alexj0i/2425_projet1a_pedale_midi/README.md

# Projet 1A Pédale MIDI

Ce projet vise à concevoir une pédale autonome destinée aux musiciens souhaitant contrôler facilement des sons MIDI. L'utilisateur peut naviguer entre différents programmes MIDI grâce à deux boutons **UP/DOWN**, et ajuster en temps réel un paramètre tel que le **volume** ou la **modulation** via une **pédale d’expression analogique**.

## Sommaire

- [Équipe](#équipe)
- [Description des dossiers](#description-des-dossiers)
- [Cahier des charges](#cahier-des-charges)
- [I. Partie Hardware](#i-partie-hardware)
  - [Architecture générale](#architecture-générale)
  - [Schéma électronique](#schéma-électronique)
  - [Détail des blocs matériels](#détail-des-blocs-matériels)
    - [1. Microcontrôleur](#1-microcontrôleur)
    - [2. Alimentation](#2-alimentation)
    - [3. Entrée analogique – Pédale d’expression](#3-entrée-analogique--pédale-dexpression)
    - [4. Affichage LED 7 segments](#4-affichage-led-7-segments)
    - [5. Entrées utilisateur – Boutons poussoirs](#5-entrées-utilisateur--boutons-poussoirs)
    - [6. Communication MIDI](#6-communication-midi)
    - [7. Programmation / Debug](#7-programmation--debug)
  - [Conception du PCB](#conception-du-pcb)
    - [Organisation des couches](#organisation-des-couches)
    - [Placement des composants](#placement-des-composants)
    - [Routage et bonnes pratiques](#routage-et-bonnes-pratiques)
    - [Fonctions complémentaires](#fonctions-complémentaires)
- [II / PARTIE SOFTWARE](#iipartie-software)
  - [Notions clefs](#notions-clefs)
    - [1. Définition du MIDI](#1-definition-du-midi)
    - [2. Forme d’un message MIDI](#2-forme-dun-message-midi)
  - [Objectifs de programmation](#objectifs-de-programmation)
    - [1. Interaction entre la STM32, les périphériques d’entrée et le système MIDI](#1-interaction-entre-la-stm32-les-périphériques-dentrée-et-le-système-midi)
    - [2. Les éléments à coder](#2-les-élements-à-coder)
  - [Code et projet](#code-et-projet)
    - [1. Agencement du projet dans STM32CubeIDE](#1-agencement-du-projet-dans-stm32cubeide)
    - [2. Le code et explications détaillées](#2-le-code-et-explications-détaillées)

  - [3. Paramétrage de la STM32 (pin, TIMER, interruptions)](#3-paramétrage-de-la-stm32-pin-timer-interruptions-)
  - [4. Résumé du fonctionnement SOFTWARE](#4-résumé-du-fonctionnement-software)
- [III / PARTIE TEST FONCTIONNEL](#iii-partie-test-fonctionnel)
    - [Test des boutons UP / DOWN](#test-des-boutons-up--down)
    - [Test de la pédale](#test-de-la-pédale-dexpression)
    - [Test de l'afficheur](#test-de-laffichage-7-segments)
    - [Test de l'alimentation](#test-de-lalimentation)

## Équipe  
- **TURGUT Iprahim**  
- **PREVOST Alexian**  
- **CHERIFI Sacha**

## Description des dossiers 
- Doc : 
  - datasheets
      * Fichier g21u.pdf : documentation technique du pédalier "Guitar Effects Pedal G2.1u".
      * Fichier NJL5167K.pdf : documentation  technique du capteur photoélectrique.
      * Fichier DTA123JCAHZGT116 : documentation technique du transistor.
      * Schema ampliOp original
  - ImgReadme
      *  Stockage des images pour le compte rendu
  - Presentation du projet : 2425_presentation_projets_1A_Fiack.pdf
- Hardware :
    * On retrouve ici la schématique ainsi que le PCB du projet réalisé sur le logiciel Kicad.
- Software :
    * Emplacement de la partie programmation sur le logiciel STM32CubeIde. 

## Cahier des charges 

Le projet "Pédale MIDI" a pour objectif de développer une pédale MIDI autonome permettant à un utilisateur, notamment un musicien, de naviguer entre différents sons MIDI à l’aide de deux boutons (UP/DOWN) et de contrôler en temps réel un paramètre comme le volume ou la modulation via une pédale d’expression analogique. Le système repose sur un microcontrôleur STM32G431KBTx chargé de gérer les entrées (boutons et pédale via GPIO et ADC), l’affichage du programme sélectionné sur un écran 7 segments double via un multiplexage piloté par un timer (TIM4), et la transmission des messages MIDI (Program Change et Control Change) au format UART vers un PC ou un instrument. Le dispositif doit être compact, alimenté en 5V avec régulation locale en 3.3V, intégrer un affichage clair et une connectique accessible, tout en respectant des contraintes de stabilité, de simplicité d'utilisation et de fiabilité en conditions de jeu.

## I / PARTIE HARDWARE

### Architecture Générale

Le système repose sur une carte STM32 qui centralise la lecture des entrées (pédale, boutons), l'afficheur 7 segments, et la transmission MIDI via UART. L’ensemble est alimenté en **3,3 V**, régulé à partir d’une source **+5 V**.

---

### Schéma Électronique

Le schéma du projet a été réalisé sur **KiCad**. Voici le visuel de la schématique ci-dessous :

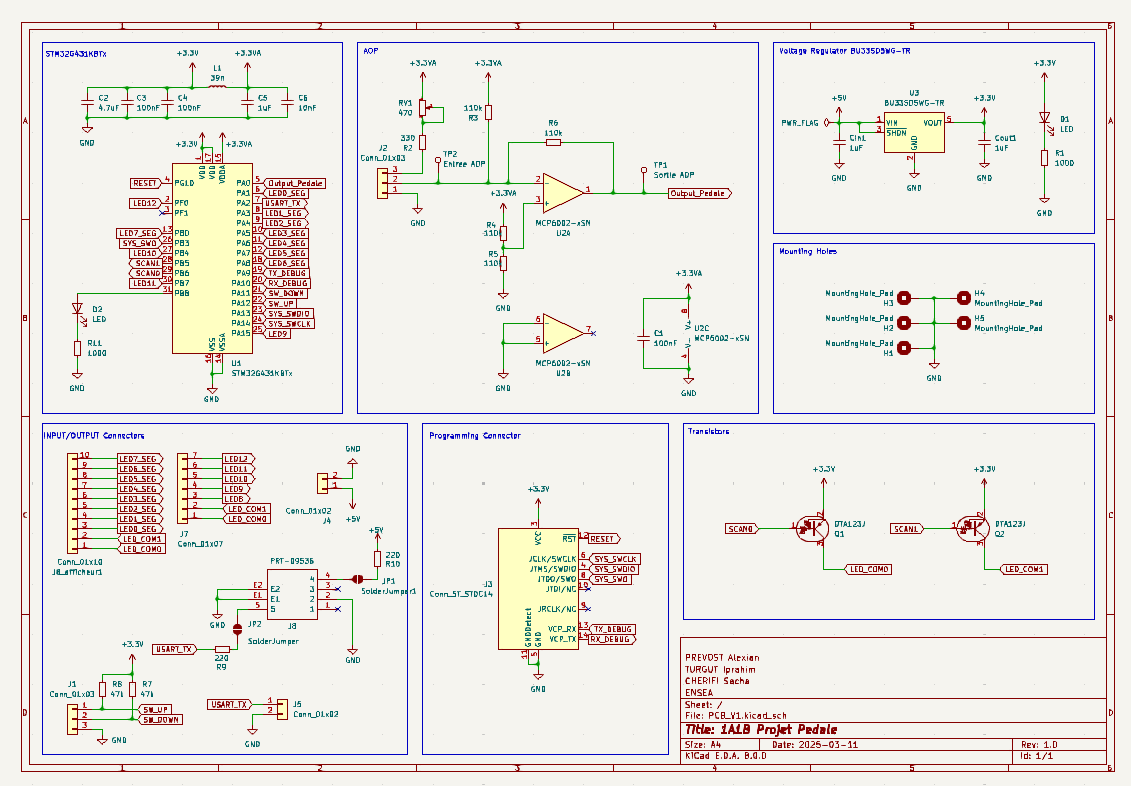
[picture p1: Doc/ImgReadme/Schematique_pedale.PNG]
.

Il contient :

- **Unité centrale** : STM32G431KBTx
- **Conditionnement du signal de pédale** via AOP
- **Commande des LED 7 segments** avec transistors PNP à résistances intégrées
- **Régulation d’alimentation 5V → 3.3V**
- **Connecteurs** : connecteur STDC14 entrées boutons, affichage LED, communication série

---

### Détail des blocs matériels

#### 1. Microcontrôleur
- **Référence** : STM32G431KBTx  
- **Architecture** : ARM Cortex-M4, fréquence max 170 MHz  
- **Format** : LQFP-32  
- **Périphériques utilisés** :
  - **ADC1** pour lire la tension envoyée par la pédale (valeur analogique)
  - **GPIOs** pour lire l'état des boutons UP/DOWN
  - **EXTI** pour gérer les interruptions sur appuis bouton / pédale
  - **USART1 (UART)** pour la communication MIDI (sortie TX)
  - **TIM4** pour gérer le multiplexage de l'afficheur 7 segments (interruption périodique)
- **Alimentation** : 3.3V régulée par LDO
- **Avantages** :
  - Microcontrôleur puissant et polyvalent
  - Intégration de nombreuses fonctionnalités sur un boîtier compact

#### 2. Alimentation
- **Composant principal** : BU33SD5WG-TR (Régulateur LDO)
- **Entrée** : +5V (via connecteur J5)
- **Sortie** : +3.3V (pour alimenter le microcontrôleur, les transistors, l’AOP)
- **Protection / filtrage** :
  - **Condensateurs** d’entrée et de sortie (1 µF chacun)
  - **LED** de visualisation d'alimentation (D1)
- **Pourquoi ce choix ?**
  - Faible dropout voltage
  - Très faible consommation de repos
  - Format compact (SOT-23-5)

#### 3. Entrée analogique – Pédale d’expression
- **Signal d’entrée** : tension analogique entre 0 V et 3.3 V issue d’un capteur optique (NJL5167K)
- **Conditionnement du signal** :
  - Utilisation d’un double AOP : **MCP6002**
    - Canal 1 : buffer (impédance d’entrée élevée, stabilité)
    - Canal 2 : amplificateur non-inverseur (gain défini par R6/R4)
  - **Potentiomètre (RV1 = 470 Ω)** pour réglage fin du gain ou de la tension de référence
  - **Filtrage** : R et C en entrée pour atténuer les perturbations haute fréquence
- **Pourquoi ce choix ?**
  - MCP6002 est un AOP **rail-to-rail**, faible consommation, économique
  - Compatible avec alimentation 3.3V

#### 4. Afficheur LED 7 segments
- **Nombre de chiffres** : 2 chiffres (double afficheur)
- **Commande** :
  - **Multiplexage** : affichage alterné via interruptions du TIM4
  - **Segments (a–g)** câblés en parallèle sur un port GPIO (ex: GPIOB)
  - **Anodes communes** : activées alternativement via 2 transistors
- **Transistors utilisés** :
  - **DTA123J** (Q1, Q2)
    - Transistors PNP avec résistances intégrées (R1 = 2.2 kΩ, R2 = 47 kΩ)
    - Pilotés par le microcontrôleur (commutation rapide, faible encombrement)
- **Pourquoi ce choix ?**
  - Réduction du nombre de broches GPIO (affichage multiplexé)
  - Meilleure lisibilité pour l’utilisateur
  - Moins de composants passifs nécessaires grâce aux transistors "pré-polarisés"

#### 5. Entrées utilisateur – Boutons poussoirs
- **Boutons** :
  - UP (J6) et DOWN (J6)
  - Pull-down via résistances de 47 kΩ (R7, R8)
  - Connexions sur GPIOs avec **interruptions EXTI**
- **Utilisation** :
  - Sélection de presets MIDI (valeurs entre 0 et 127)
  - Incrémentation / décrémentation de la variable `globalToDisplay`
- **Protection / rebond logiciel** :
  - Anti-rebond logiciel via `HAL_GetTick()` + temporisation 50 ms

#### 6. Communication MIDI
- **Interface** : UART via USART1
- **Niveau logique** : TTL 3.3V (compatible PC ou interface MIDI-USB)
- **Format des messages** :
  - **Program Change** : `[0xC0, num_programme]`
  - **Control Change** : `[0xB0, effet, valeur]`
- **Utilisation** :
  - Envoi vers un PC ou un synthétiseur logiciel
  - Communication unidirectionnelle (TX uniquement)

#### 7. Programmation / Debug
- **Connecteur STDC14 (J3)** :
  - Connexion au programmateur ST-Link
  - Accès aux signaux :
    - SWCLK, SWDIO (programmation/debug)
    - TX_DEBUG, RX_DEBUG (UART secondaire pour impression/log)
- **Pourquoi ce choix ?**
  - Connecteur standard ST utilisé à l’ENSEA
  - Facilité de reprogrammation et débogage en temps réel

## Conception du PCB

La carte électronique de la pédale MIDI a été conçue avec **KiCad** et repose sur un **PCB 4 couches**, permettant une organisation optimisée des signaux, de l’alimentation et du plan de masse.

---

### Organisation des couches

Le PCB utilise 4 couches réparties comme suit :

- **Couche 1 (Top Layer)** : Routage principal des signaux (GPIO, UART, ADC, affichage…).
- **Couche 2 (Inner Layer 1)** : Plan de masse complet, essentiel pour limiter les perturbations et garantir des références stables.
- **Couche 3 (Inner Layer 2)** : Plan d’alimentation (+ 3.3 V et + 3.3 VA), isolé du plan de masse pour éviter les couplages indésirables.
- **Couche 4 (Bottom Layer)** : Routage secondaire, signaux de commande, entrées utilisateur et connexions vers les périphériques.

Cette structure améliore la **stabilité électrique**, **limite les interférences**, et permet une **meilleure compacité** du design.

---

### Placement des composants

Le placement a été réfléchi selon une logique de blocs fonctionnels :

- Le **microcontrôleur STM32G431KBTx** est centré sur la carte pour limiter la longueur des pistes critiques.
- La **section AOP + pédale** est placée en bas à gauche, proche du connecteur J2 pour une lecture propre du signal analogique.
- Le **régulateur de tension (BU33SD5WG)** est positionné en haut à proximité des entrées d’alimentation (J4/J5).
- Les **transistors Q1 et Q2 (DTA123J)** sont proches du connecteur LED J7, pour commander les chiffres du double 7 segments.
- Tous les **connecteurs** sont en périphérie pour un accès facile :
  - J2 pour la pédale
  - J5 pour l’alimentation
  - J7 pour l’écran LED
  - J3 (STDC14) pour le débogage
  - J6 pour les boutons poussoirs

---

### Routage et bonnes pratiques

- **Pistes d’alimentation** élargies pour minimiser les chutes de tension.
- **Condensateurs de découplage** positionnés au plus près des broches VDD du microcontrôleur.
- **Vias traversants** utilisés avec parcimonie pour relier efficacement les couches.
- Les signaux sensibles (notamment le **signal ADC**) ont été routés avec soin pour éviter les interférences.
- Le **multiplexage de l'affichage** a été routé de façon à réduire les croisements de pistes.

---

### Fonctions complémentaires

- **Jumpers JP1/JP2** : utilisés pour activer ou désactiver certaines fonctions (ex : liaison série ou configuration debug).
- **Points de test TP1/TP2** : permettent de vérifier le signal analogique traité par les AOP.
- **Trous de fixation** (H1–H5) : assurent une intégration mécanique solide de la carte dans un boîtier.

---

### Aperçu du PCB
  
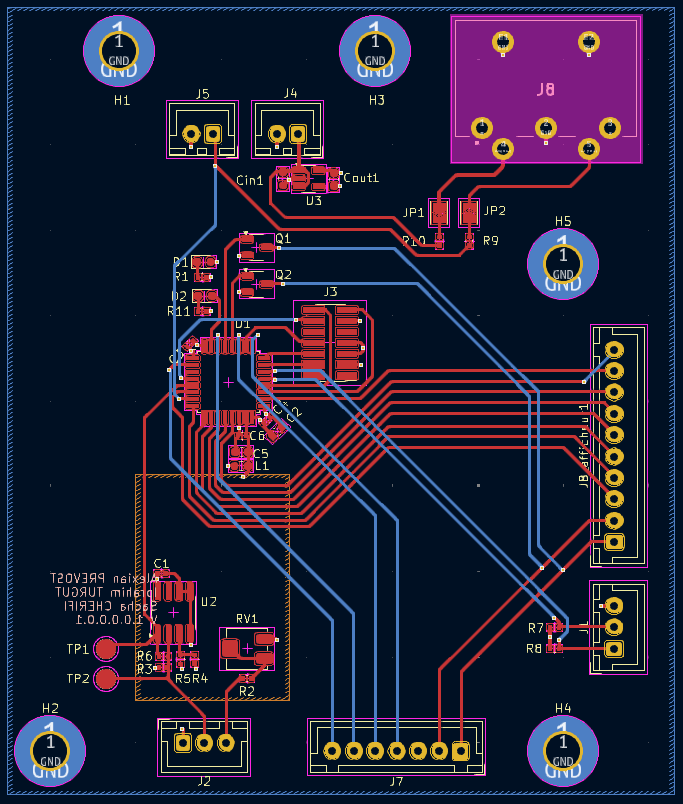
[picture p2: Doc/ImgReadme/PCB_pedale.PNG]
> .
> *Vue du routage et du placement des composants sur 4 couches.*

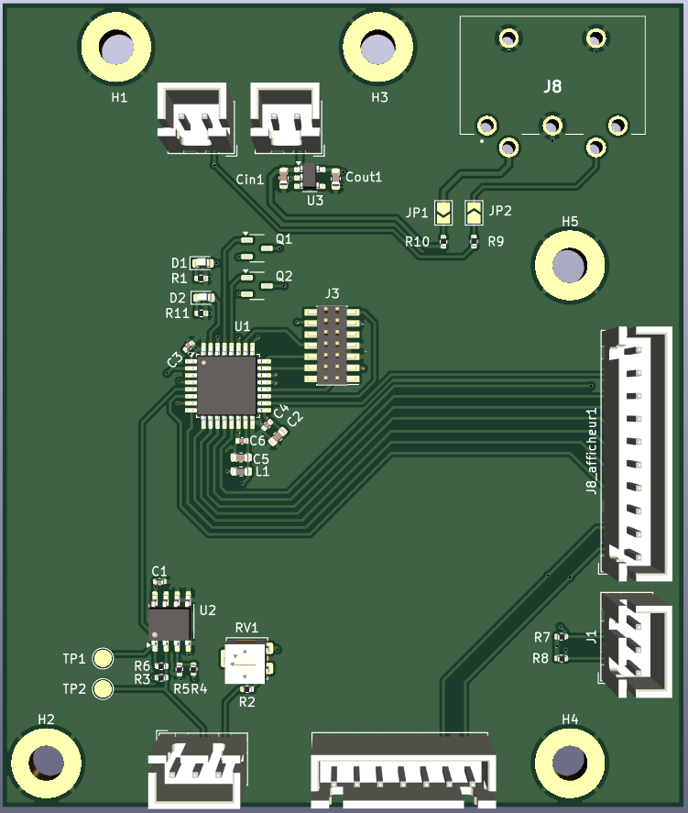
[picture p3: Doc/ImgReadme/Visu3D_pedale.PNG]
> .
> *Vue en 3D du PCB*

### Justification du choix des composants

| Composant | Rôle | Justification |
|---|---|---|
| STM32G431KBTx | Contrôle principal | Compatibilité ADC, UART, TIM, GPIO. Format compact. |
| MCP6002 | AOP pour pédale | Rail-to-rail, faible consommation, économique. |
| DTA123J | Commutation LED | Transistors PNP avec résistances intégrées → gain de place. |
| BU33SD5WG | Régulateur | Régulation stable 3.3V, faible chute de tension. |
| RV1 (470 Ω) | Réglage de gain | Permet un calibrage manuel de la pédale. |
| Afficheur 7 segments| Retour visuel utilisateur| Simple, lisible, facilement multiplexé avec 2 chiffres. |

# II/PARTIE SOFTWARE
# Notions clefs
## **1. DEFINITION DU MIDI**
Le **MIDI** (abréviation de **Musical Instrument Digital Interface**) est un Protocole de communication et un format de fichier destinés à la musique, et utilisés pour la communication entre instruments électroniques, contrôleurs, séquenceurs, et logiciels de musique.
## **2. FORME D'UN MESSAGE MIDI** 

| Message |Status | Data1|Data2|
|---|---|---|---|
|Control Change (CC)|1011 CCCC |Control number (0-119) |Value (0-127)|
| Program Change | 1100 CCCC | Program number |N/A |

* **Control Change**
>Envoie un message MIDI pour contrôler un effet ( exemple : le volume , un pédale d'expression , etc )
>> * **Byte de statut (`status`)**
>>  De la forme `0xBn` :
>>`B` indique qu’il s’agit d’un message Control Change 
>>`n` indique le numéro du canal MIDI ( de 0 à 15 soit les channels MIDI de 1 à 16 ).
>>Dans notre cas, le **byte de statut** sera toujours égal à `0xB0`, car `B` indique un message de type **Control Change**, et nous utilisons arbitrairement le **canal 0**, qui correspond au **canal MIDI 1**.
>
>> * **Byte de la premiere donnée (`data1`)**
>> data1 est le numéro du contrôleur c'est à dire l'effet appliqué ( de 0 à 127 ). 
>
>> * **Byte de la deuxième donnée (`data2`)**
>data 2 est la valeur du contrôleur c'est à dire la valeur de l'effet souhaité ( de 0 à 127 ). 
>
>***Exemple pratique**: On veut envoyer une message Control Change sur le cannal MIDI 1 de manière à mettre le volume le plus fort possible. On prendra  :
>Message = [0xB0, 7, 127]*

* **Program Change**
>Envoie un message MIDI pour changer de preset ou d'instrument VST.
>> * **Byte de statut (`status`)**
>>  De la forme `0xCn` :
>>`C` indique qu’il s’agit d’un message Program Change 
>>`n` indique le numéro du canal MIDI ( de 0 à 15 soit les channels MIDI de 1 à 16 ).
>>Dans notre cas, le **byte de statut** sera toujours égal à `0xC0`, car `C` indique un message de type **Control Change**, et nous utilisons arbitrairement le **canal 0**, qui correspond au **canal MIDI 1**.
>
>> * **Byte de la premiere donnée (`data1`)**
>> data1 est le numéro du programme c'est à dire le preset ou l'instrument ( de 0 à 127 ). 
>
>> * **Byte de la deuxième donnée (`data2`)**
>data2 n'est **pas utilisée.**
>
>***Exemple pratique**: On veut envoyer une message Program Change sur le cannal MIDI 1 de manière à utiliser un son de piano ( 0 pour un Acoustic Grand Piano dans la banque de sons MIDI ) . On prendra alors:
>Message = [0xC0, 0]*
>

# Objectifs  de programmation
## **1. Interaction entre la STM32, les périphériques d’entrée et le système MIDI**
```mermaid
graph TD
    A[Bouton +/-] -->|GPIO EXTI| B[STM32]
    C[Pédale] -->|ADC + EXTI| B
    B -->|UART MIDI | D[PC: Logiciel MIDI]
    B -->|TIM4 + Screen_display| E[Écran 7 segments 2 chiffres]
```
## **2. Les élements à coder**
 * **Ecran 7 cadrants 2 chiffres**
>Affiche le numéro du son sélectionné dans la banque MIDI.  
Ce numéro est mis à jour selon l’appui sur les boutons **UP** ou **DOWN**.  
L’écran offre un retour visuel clair à l’utilisateur.
>
* **Boutons de selection des sons**
>Permettent de naviguer dans la banque de sons MIDI (de 0 à 127).  
Chaque appui incrémente ou décrémente le numéro de programme.
>
 * **Pedale**
>Connectée à l’**entrée ADC**, elle mesure une tension analogique.  
Sa valeur est convertie en valeur MIDI (0–127).  
Elle permet un **contrôle en temps réel** d’un paramètre MIDI (volume, sustain, etc).
>
 * **Communication MIDI**
>La STM32 envoie les messages MIDI via **UART**.  
Elle transmet les changements de sons ou de contrôle vers un PC.
La STM32 agit comme **contrôleur MIDI autonome**.

# **Code et projet**
## **1. Agencement du projet dans STM32CubeIDE**
```mermaid
classDiagram
    class Main {
        <<main.c>>
        int last_button_time
        void HAL_GPIO_EXTI_Callback()
        void HAL_TIM_PeriodElapsedCallback()
    }

    class MIDI {
        <<midi.c>>
        void ProgramChange(int MIDISoundNumber)
        void ControlChange(int pedalValue, int effect)
        int ADValue()
    }

    class Screen {
        <<screen.c>>
        int array
        int global_to_display
        void screen_display()
    }

    Main --> MIDI : appelle
    Main --> Screen : appelle
    Screen --> MIDI : utilise global_to_display

```
## **2. Le code et explications détaillées**
**Contenu du midi.c :** 
* **Fonction ControlChange**
```
void  ControlChange(int pedalValue, int effect)
{
int message[3] = {0xB0, effect, pedalValue}; 
HAL_UART_Transmit(&huart1, message, 3, HAL_MAX_DELAY);
}
```
>--- ***Pourquoi cette fonction ?*** ---
>
>Un **Control Change** permet de **modifier des paramètres en temps réel**, comme le volume.
> * `message[3]` est un tableau de 3 octets, correspondant à un message **MIDI Control Change**. Ici, le message MIDI signifie :  *"Change la valeur de l'`effect` voulu sur le canal MIDI 1 avec la valeur `pedalValue`."*
>* La fonction `HAL_UART_Transmit` envoie ce message via la liaison **série UART**.

* **Fonction ProgramChange**
```
void ProgramChange(int MIDISoundNumber)
{
int message[2] = {0xC0, MIDISoundNumber};
HAL_UART_Transmit(&huart1, data, 2, HAL_MAX_DELAY);
}
```
>--- ***Pourquoi cette fonction ?*** ---
>
>Un **Program Change** permet de **changer le son ou le preset** utilisé par  l'instrument.
> * `message[2]` est un tableau de 2 octets, correspondant à un message **MIDI Program Change**. Ici, le message MIDI signifie :  *"Change le programme (son) de l'instrument sur le canal 1 pour le programme `MIDISoundNumber`."*
>* La fonction `HAL_UART_Transmit` envoie ce message via la liaison **série UART**.

* **Fonction  pour le potentiometre (valeur ADC)**
``` 
uint8_t ADCValue(void)
{
    HAL_ADC_Start(&hadc1);
    HAL_ADC_PollForConversion(&hadc1, HAL_MAX_DELAY);
    uint32_t lastADCValue = HAL_ADC_GetValue(&hadc1); 
    HAL_ADC_Stop(&hadc1); // economie d'energie on éteint l'adc si il n'est pas utilisé.
    return (uint8_t)((lastADCValue * 127) / 4095);
}
```
>--- ***Pourquoi cette fonction ?*** ---
>
> Un **ADC** (Analog-to-Digital Converter) permet de convertir une **tension analogique** (par exemple entre **0V et 3.3V**) en une **valeur numérique** exploitable par un microcontrôleur.  
Si l’ADC est en **résolution 12 bits**, il produit des valeurs comprises entre **0 et 4095**. Or, dans le protocole **MIDI**, les données comme les valeurs de contrôle sont codées sur **7 bits**, c’est-à-dire de **0 à 127**.
Ainsi, pour utiliser une valeur provenant de l’ADC dans un message MIDI, il est nécessaire de convertir la plage **0–4095** vers la plage **0–127**.
>* `HAL_ADC_PollForConversion(&hadc1, HAL_MAX_DELAY)` permet d'attendre que la conversion se fasse correctement.
>* `HAL_ADC_GetValue(&hadc1)` lit la dernière **valeur convertie par l’ADC**.
>`adcValue` sera une valeur comprise entre **0 et 4095** (12 bits).
>
> * `(uint8_t)((adcValue * 127) / 4095)` **convertit** la valeur 12 bits (0–4095) en 7 bits (0–127), proportionnellement  et le **cast** en `(uint8_t)` assure que la valeur retournée est bien entre 0 et 127.

**Contenu du midi.h :** 
```
#include "main.h"

#define BUTTON_UP GPIO_PIN_12
#define BUTTON_DOWN GPIO_PIN_11
#define PEDAL GPIO_PIN_0
#define EFFECT 7 //Volume

void ProgramChange(int MIDISoundNumber);
void ControlChange(int pedalValue, int effect);
uint8_t ADCValue(void);
```

**Contenu du screen.c :** 
* **Multiplexage pour l'affichage de l'écran 7 cadrants**
```
int globalToDisplay;

//Ordre : A B C D E F G (mappés sur bits 1 3 4 5 6 7 8)
const uint16_t array[10] = {
    (0<<1)|(0<<3)|(0<<4)|(0<<5)|(0<<6)|(0<<7)|(1<<8), // 0
    (1<<1)|(0<<3)|(0<<4)|(1<<5)|(1<<6)|(1<<7)|(1<<8), // 1
    (0<<1)|(0<<3)|(1<<4)|(0<<5)|(0<<6)|(1<<7)|(0<<8), // 2
    (0<<1)|(0<<3)|(0<<4)|(0<<5)|(1<<6)|(1<<7)|(0<<8), // 3
    (1<<1)|(0<<3)|(0<<4)|(1<<5)|(1<<6)|(0<<7)|(0<<8), // 4
    (0<<1)|(1<<3)|(0<<4)|(0<<5)|(1<<6)|(0<<7)|(0<<8), // 5
    (0<<1)|(1<<3)|(0<<4)|(0<<5)|(0<<6)|(0<<7)|(0<<8), // 6
    (0<<1)|(0<<3)|(0<<4)|(1<<5)|(1<<6)|(1<<7)|(1<<8), // 7
    (0<<1)|(0<<3)|(0<<4)|(0<<5)|(0<<6)|(0<<7)|(0<<8), // 8
    (0<<1)|(0<<3)|(0<<4)|(0<<5)|(1<<6)|(0<<7)|(0<<8), // 9
};

void  screenDisplay(void) 
{
static  int displayNumber = 0;
	//Effacement de la virgule pour l'afficheur
    HAL_GPIO_WritePin(GPIOB, DOT_PIN, GPIO_PIN_SET);

	//Initialisation des segments (1,3,4,5,6,7,8)
		GPIOA->ODR &= ~( (1<<1) | (1<<3) | (1<<4) | (1<<5) | (1<<6) | (1<<7) | (1<<8) );
		
if (displayNumber == 0) 
	{
	GPIOB->ODR = array[globalToDisplay / 10];
	HAL_GPIO_WritePin(GPIO_PORT_B, COM0, GPIO_PIN_SET); // COM0 = 1
	HAL_GPIO_WritePin(GPIO_PORT_B, COM1, GPIO_PIN_RESET); // COM1 = 0
} 

else
	{
	GPIOB->ODR = array[globalToDisplay % 10]; 
	HAL_GPIO_WritePin(GPIO_PORT_B, COM0, GPIO_PIN_RESET); // COM0 = 0
	HAL_GPIO_WritePin(GPIO_PORT_B, COM1, GPIO_PIN_SET); // COM1 = 1
	}
	displayNumber = 1 - displayNumber;
}
```
>--- ***Pourquoi cette fonction ?*** ---
>
>`screenDisplay()` qui gère l’affichage des deux chiffres d’un écran 7 segments. Grâce au multiplexage, chaque chiffre est allumé alternativement très rapidement, ce qui donne l’illusion qu’ils sont allumés en même temps.
> * `globalToDisplay`contient **le nombre à afficher** (entre 0 et 99).
> * `const uint8_t array[10]` contient les **valeurs binaires** à envoyer aux segments (a–g) du 7 segments pour afficher les chiffres de 0 à 9.
>> Si on doit afficher **le chiffre des dizaines** (` if (displayNumber == 0) `)
> `GPIOB->ODR = array[globalToDisplay / 10];` permet d'afficher le chiffre des dizaines sur l'écran 7 segments. Elle divise la valeur `globalToDisplay` par 10 pour extraire le chiffre des dizaines, puis utilise ce résultat comme index dans le tableau `array` pour récupérer le motif binaire correspondant aux segments à allumer. Ensuite, ce motif est écrit dans le registre `GPIOB->ODR`, ce qui active les bons segments du chiffre sur l'afficheur.
Les commandes :
>`HAL_GPIO_WritePin(GPIO_PORT_B, COM0, GPIO_PIN_SET); 
>HAL_GPIO_WritePin(GPIO_PORT_B, COM1, GPIO_PIN_RESET); `
Activent le chiffre des dizaines et désactive le chiffre des unités.
>> Si on doit afficher **le chiffre des unités** (`else`)
>  `GPIOB->ODR = array[globalToDisplay % 10];` fait de même que précèdemment pour le chiffre des unités.
Les commandes :
>`HAL_GPIO_WritePin(GPIO_PORT_B, COM0, GPIO_PIN_RESET); 
>HAL_GPIO_WritePin(GPIO_PORT_B, COM1, GPIO_PIN_SET); `
Activent le chiffre des unités et désactive le chiffre des dizaines.
>* `displayNumber = 1 - displayNumber;`
Alterne la valeur de `displayNumber` entre 0 et 1 à chaque appel. Elle permet de basculer l’affichage entre les deux chiffres du 7 segments pour réaliser le multiplexage.

**Contenu du screen.h :** 
```
#include "main.h"

#define DOT_PIN GPIO_PIN_0 
#define GPIO_PORT_B GPIOB
#define COM0 GPIO_PIN_5
#define COM1 GPIO_PIN_6

// Variable globale pour stocker le nombre à afficher
extern int globalToDisplay;

void screenDisplay(void);
```

**Contenu du main.c :** 
* **Interruptions et TIMER**
```
int lastButtonTime = 0; 

void  HAL_TIM_PeriodElapsedCallback(TIM_HandleTypeDef *htim) 
{
if (htim->Instance == TIM4)
	{
	screenDisplay();
	ControlChange(ADCValue(), EFFECT); // Il faudrait faire un autre TIMER pour cette ligne
	}
}

void  HAL_GPIO_EXTI_Callback(int GPIO_Pin)
{
if ((HAL_GetTick() - lastButtonTime) > 50)
	{ 
	switch(GPIO_Pin)
		{
		case BUTTON_UP:
			globalToDisplay++;
			if (globalToDisplay > 127)
				{
				}
			ProgramChange(globalToDisplay);
			break;
			
		case BUTTON_DOWN:
			globalToDisplay--;
			if (globalToDisplay < 0)
				{
				}
			ProgramChange(globalToDisplay);
			break;
			
	 }
	lastButtonTime = HAL_GetTick();
 }
}
```
>--- ***Pourquoi ce code ?*** ---
>
>Ce code gère **l'affichage de l'écran** et la **gestion des boutons et de la pédale**. Il utilise un **TIM4** pour le multiplexage de l’écran, et des **interruptions GPIO** pour réagir aux appuis boutons et à la pédale.
>* `void HAL_GPIO_EXTI_Callback(int GPIO_Pin)` se déclenche automatiquement lors d’une interruption sur un bouton ou la pédale i.e lors d'un appui d'un des boutons ou de la pédale.
>> Dans le cas ou le bouton d'incrémentation est préssé (`case BUTTON_UP:`):
 On incrémente `globalToDisplay` pour passer au **son suivant** et on envoie un message MIDI **Program Change** via`ProgramChange(globalToDisplay)`.
 >>
 >>Dans le cas ou le bouton d'incrémentation est préssé (`case BUTTON_DOWN:`):
 On décrémente `globalToDisplay` pour passer au **son précédent** et on envoie un message MIDI **Program Change** via`ProgramChange(globalToDisplay)`.
 >>
>>Dans le cas ou la pédale est préssée en passant par un TIMER:
  On envoie une commande MIDI de type **Control Change** qui modifie la valeur de l'`EFFECT` suivant la valeur de la lecture de l'**ADC** via `ADCValue()`.

## **3. Paramétrage de la STM32( pin, TIMER, interruptions )**

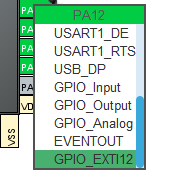
[picture p4: Doc/ImgReadme/GPIOexti.png]
.
>Les pins PA11 et PA12 correspondent aux lignes d’interruption EXTI11 et EXTI12. 

Texte alternatif Titre de l'image.
>En activant EXTI10–15, on captures les événements sur ces deux lignes donc nos appuis des boutons UP et DOWN.

Texte alternatif Titre de l'image.
>On active l’interruption du TIM4 pour que le microcontrôleur réagisse automatiquement quand le timer a fini de compter jusqu’à la valeur 7999

Texte alternatif Titre de l'image.
>On règle avec PRESCALER et ARR la vitesse d’exécution de l’interruption pour gérer l’affichage sans scintillement sur le cadran.
$`\text{Fréquence du timer} = \frac{170\,000\,000}{(19 + 1) \cdot (7999 + 1)} = 1062.5 \, \text{fois par seconde}`$

## **4. Résumé du fonctionnement SOFTWARE**
```mermaid
sequenceDiagram
    participant Bouton as Bouton/Pedalier
    participant STM32 as STM32 (Code)
    participant UART as UART (MIDI Out)
    participant PC as Logiciel MIDI (PC)

    Note over Bouton,STM32: Appui sur le bouton
    Bouton->>STM32: GPIO_EXTI_Callback(BTN_UP/BTN_DOWN)
    activate STM32

    STM32->>STM32: Anti-rebond (HAL_GetTick())
    STM32->>STM32: Inc/Déc globalToDisplay (0-127)
    STM32->>STM32: ProgramChange(globalToDisplay)

    Note over STM32,UART: Envoi MIDI (Program Change)
    STM32->>UART: UART_Transmit([0xC0, num_son])
    deactivate STM32

    UART->>PC: Message MIDI 
    activate PC
    PC->>PC: Changement de son (instrument VST)
    deactivate PC

    Note over Bouton,STM32: Mouvement de la pédale
    Bouton->>STM32: TIM_PeriodElapsedCallback
    activate STM32
    STM32->>STM32: ADCValue() → pedalValue (0-127)
    STM32->>STM32: ControlChange(pedalValue, effect)

    Note over STM32,UART: Envoi MIDI (Control Change)
    STM32->>UART: UART_Transmit([0xB0, effect, valeur])
    deactivate STM32

    UART->>PC: Message MIDI 
    activate PC
    PC->>PC: Modulation d'effet (ex : Volume)
    deactivate PC
```

# III/ PARTIE TEST FONCTIONNEL

Après la conception et l’assemblage de la carte, plusieurs tests fonctionnels ont été réalisés afin de valider le bon fonctionnement de chaque bloc du système.

### Test des boutons UP / DOWN
- **But** : Vérifier l’incrémentation ou décrémentation du programme MIDI via les boutons.
- **Méthode** : Appui répété sur les boutons tout en observant l’afficheur 7 segments et les messages MIDI envoyés.
- **Résultat attendu** : L’affichage change entre 0 et 127, et chaque appui génère un message MIDI **Program Change** correctement transmis sur l’interface UART.

Voici une image représentant l'incrémentation en appuyant sur les boutons UP/DOWN :  
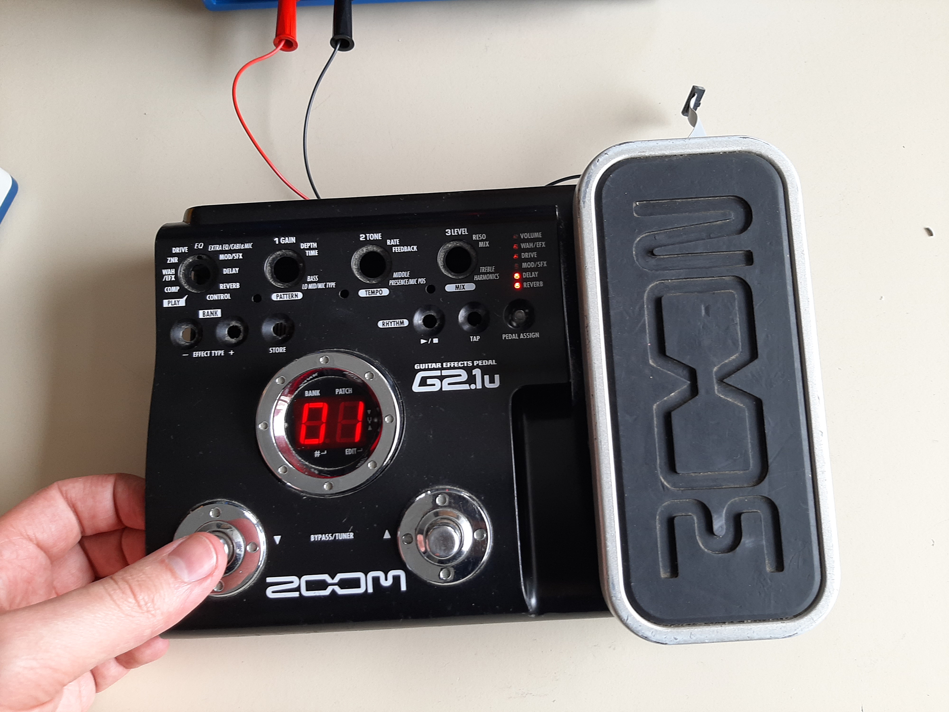
[picture p5: Doc/ImgReadme/20250526_165851.jpg]
> .

### Test de la pédale d’expression
- **But** : Vérifier que la position de la pédale est correctement traduite.
- **Méthode** : Vérification à l'aide d'un oscilloscope afin de réaliser une mesure de la tension analogique en sortie et consatater la variation de tension.
- **Résultat attendu** : La plage 0V–3.3V est bien convertie en une valeur de 0 à 127. On constate une variation de la tension à l'oscilloscope. Pour un meilleur visuel, nous avons utilisé les LEDs pour constater un variation linéaire de la tension. 

Voici des images représentant une variation de la tension, avec la pédale, à l'aide des LEDs  :
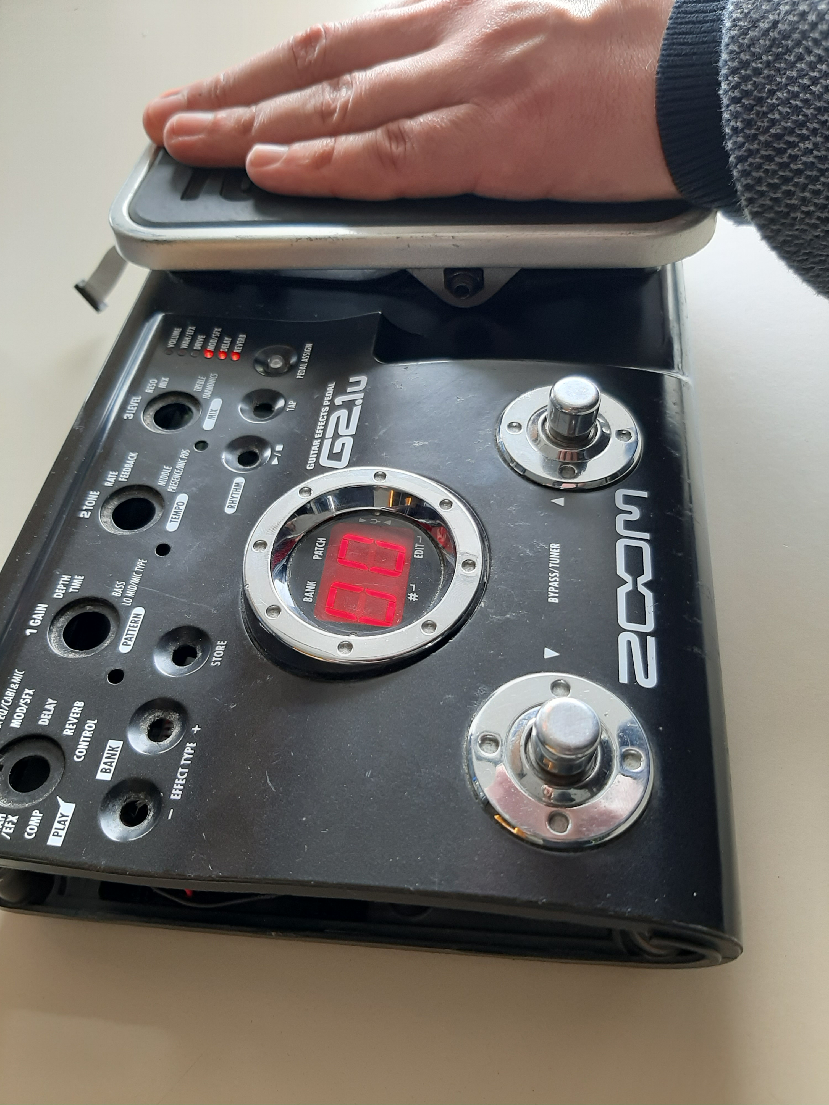
[picture p6: Doc/ImgReadme/20250526_165904.jpg]
> .
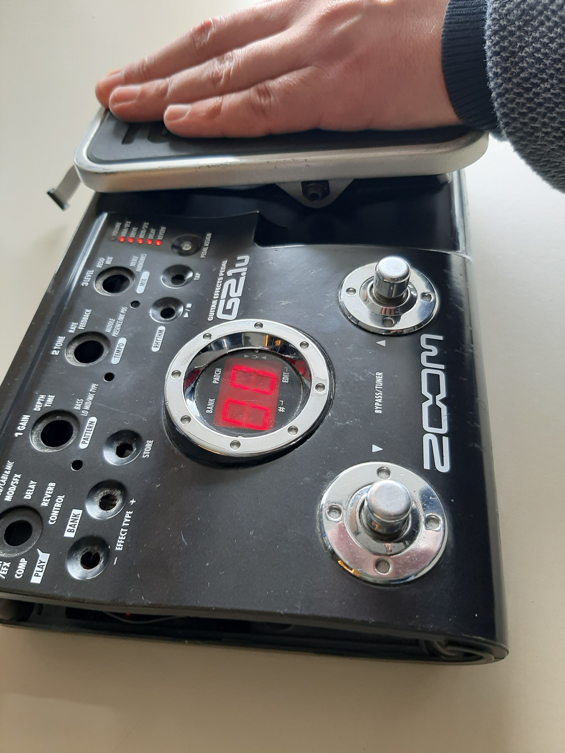
[picture p7: Doc/ImgReadme/20250526_165908.jpg]
> . 

Voici une image représentant une variation de la tension, avec la pédale, à l'aide de l'oscilloscope :

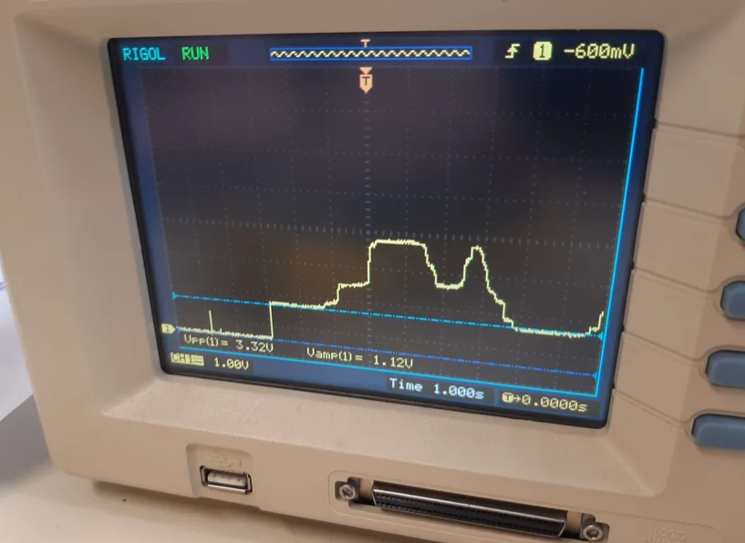
[picture p8: Doc/ImgReadme/osc1.PNG]
> .

### Test de l'afficheur 7 segments
- **But** : S’assurer que l’écran affiche correctement le numéro du programme MIDI.
- **Méthode** : Envoi manuel de valeurs de test dans la variable `globalToDisplay` (ou appui sur les boutons).
- **Résultat attendu** : Affichage stable, chiffres bien multiplexés, visibilité correcte même en environnement lumineux.

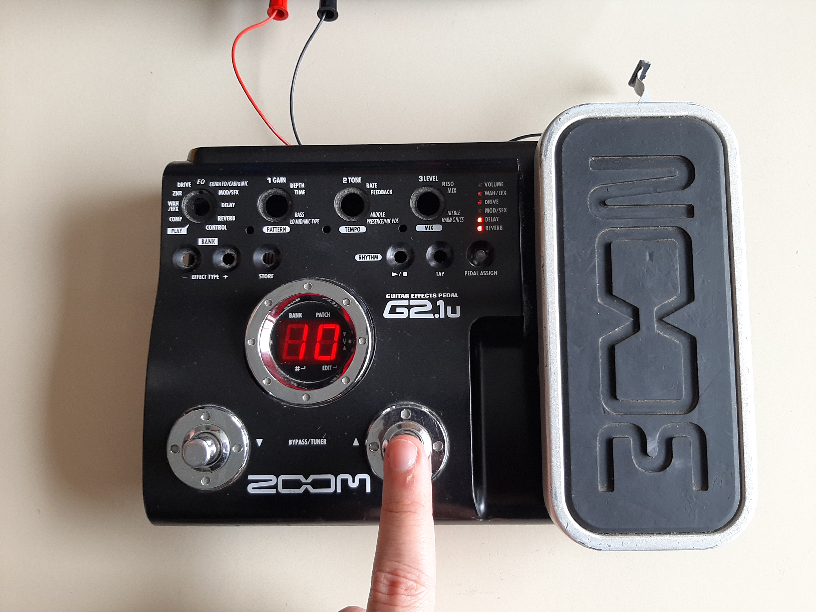
[picture p9: Doc/ImgReadme/20250526_165842.jpg]
> . 

### Test de l’alimentation
- **But** : Valider la stabilité des tensions d’alimentation 3.3V et 5V.
- **Méthode** : Mesure au multimètre, et affichage sur les LEDs.
- **Résultat attendu** : Tension de 3.3V régulée propre, sans oscillations ni chute lors de sollicitations.

## Conclusion

Le projet **Pédale MIDI** a permis de concevoir, réaliser et tester une solution matérielle et logicielle complète répondant à un besoin concret dans le domaine musical : offrir un contrôle simple, autonome et précis de paramètres MIDI via une pédale d’expression. Grâce à l’intégration d’un microcontrôleur STM32, d’un affichage 7 segments piloté en multiplexage, et d’une interface utilisateur intuitive (boutons, pédale), l’ensemble assure un fonctionnement stable et réactif.

Tous les blocs fonctionnels (lecture analogique, traitement, affichage) ont été validés par des tests pratiques, confirmant la fiabilité du système. Le recours à un PCB 4 couches a permis une implantation propre et compacte, propice à une intégration dans un boîtier de type pédale d’effet.

Ce projet nous a permis de renforcer nos compétences en électronique embarquée, conception PCB, programmation temps réel, et communication série/MIDI. Il constitue une base solide pour un futur développement de produit orienté musique numérique.
