alexj0i/2425_projet1a_pedale_midi/Doc/datasheets/Schema_ampliOP_original.png

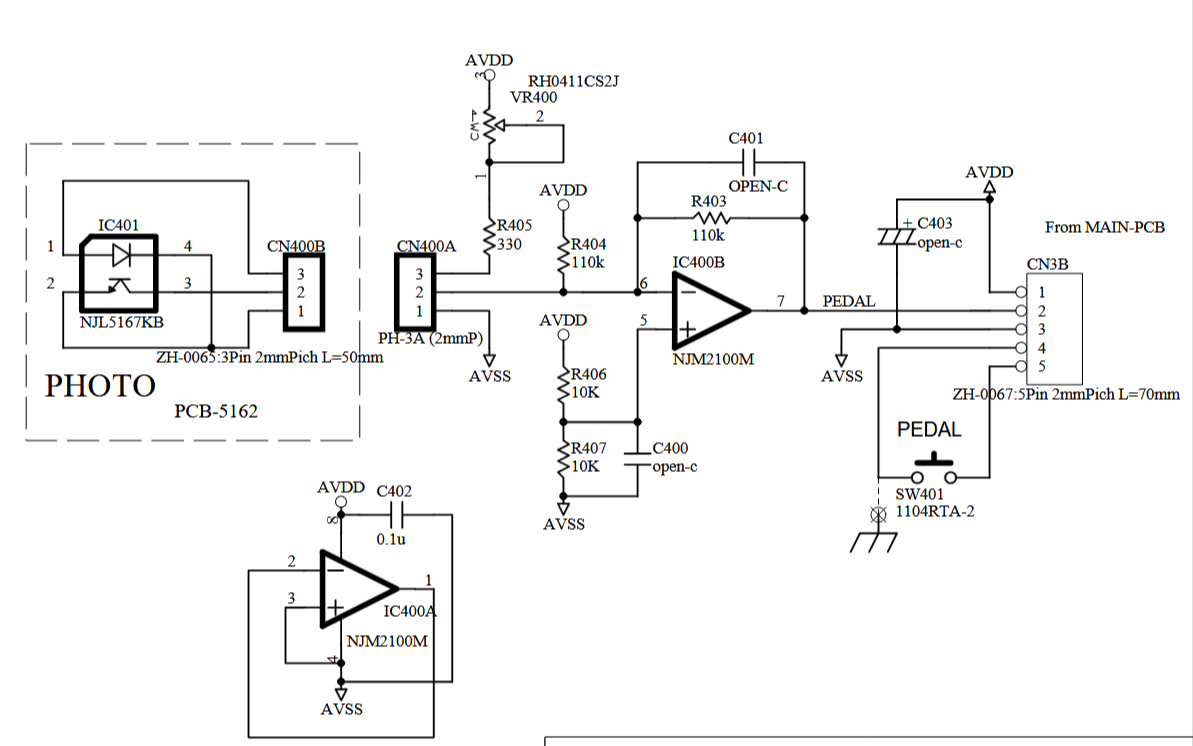
Doc/datasheets/Schema_ampliOP_original.png
