alexj0i/2425_projet1a_pedale_midi/Hardware/LIB_PRT-09536/PRT-09536/3D/PRT-09536.stp

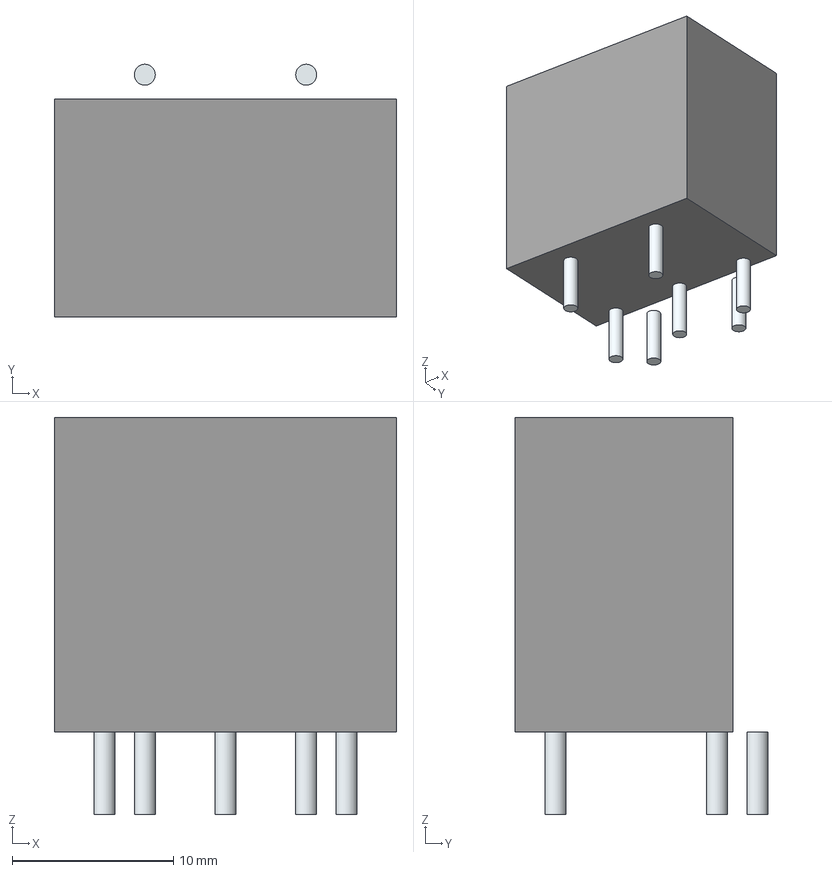
[picture p11: CAD file, 2025-05-12]
Hardware/LIB_PRT-09536/PRT-09536/3D/PRT-09536.stp
21.2 x 15.6 x 24.6 mm
Leads x 7
