alexj0i/2425_projet1a_pedale_midi/(list of files, cad)

Other CAD files:
Hardware/LIB_PRT-09536/PRT-09536/Allegro/prt09536.psm
Hardware/LIB_PRT-09536/PRT-09536/DEHDL/prt_09536/chips/chips.prt
