alexj0i/2425_projet1a_pedale_midi/Hardware/PCB/PCB_V1/PCB_V1.kicad_pcb

## KiCad design Hardware/PCB/PCB_V1/PCB_V1.kicad_pcb (2025-05-12)

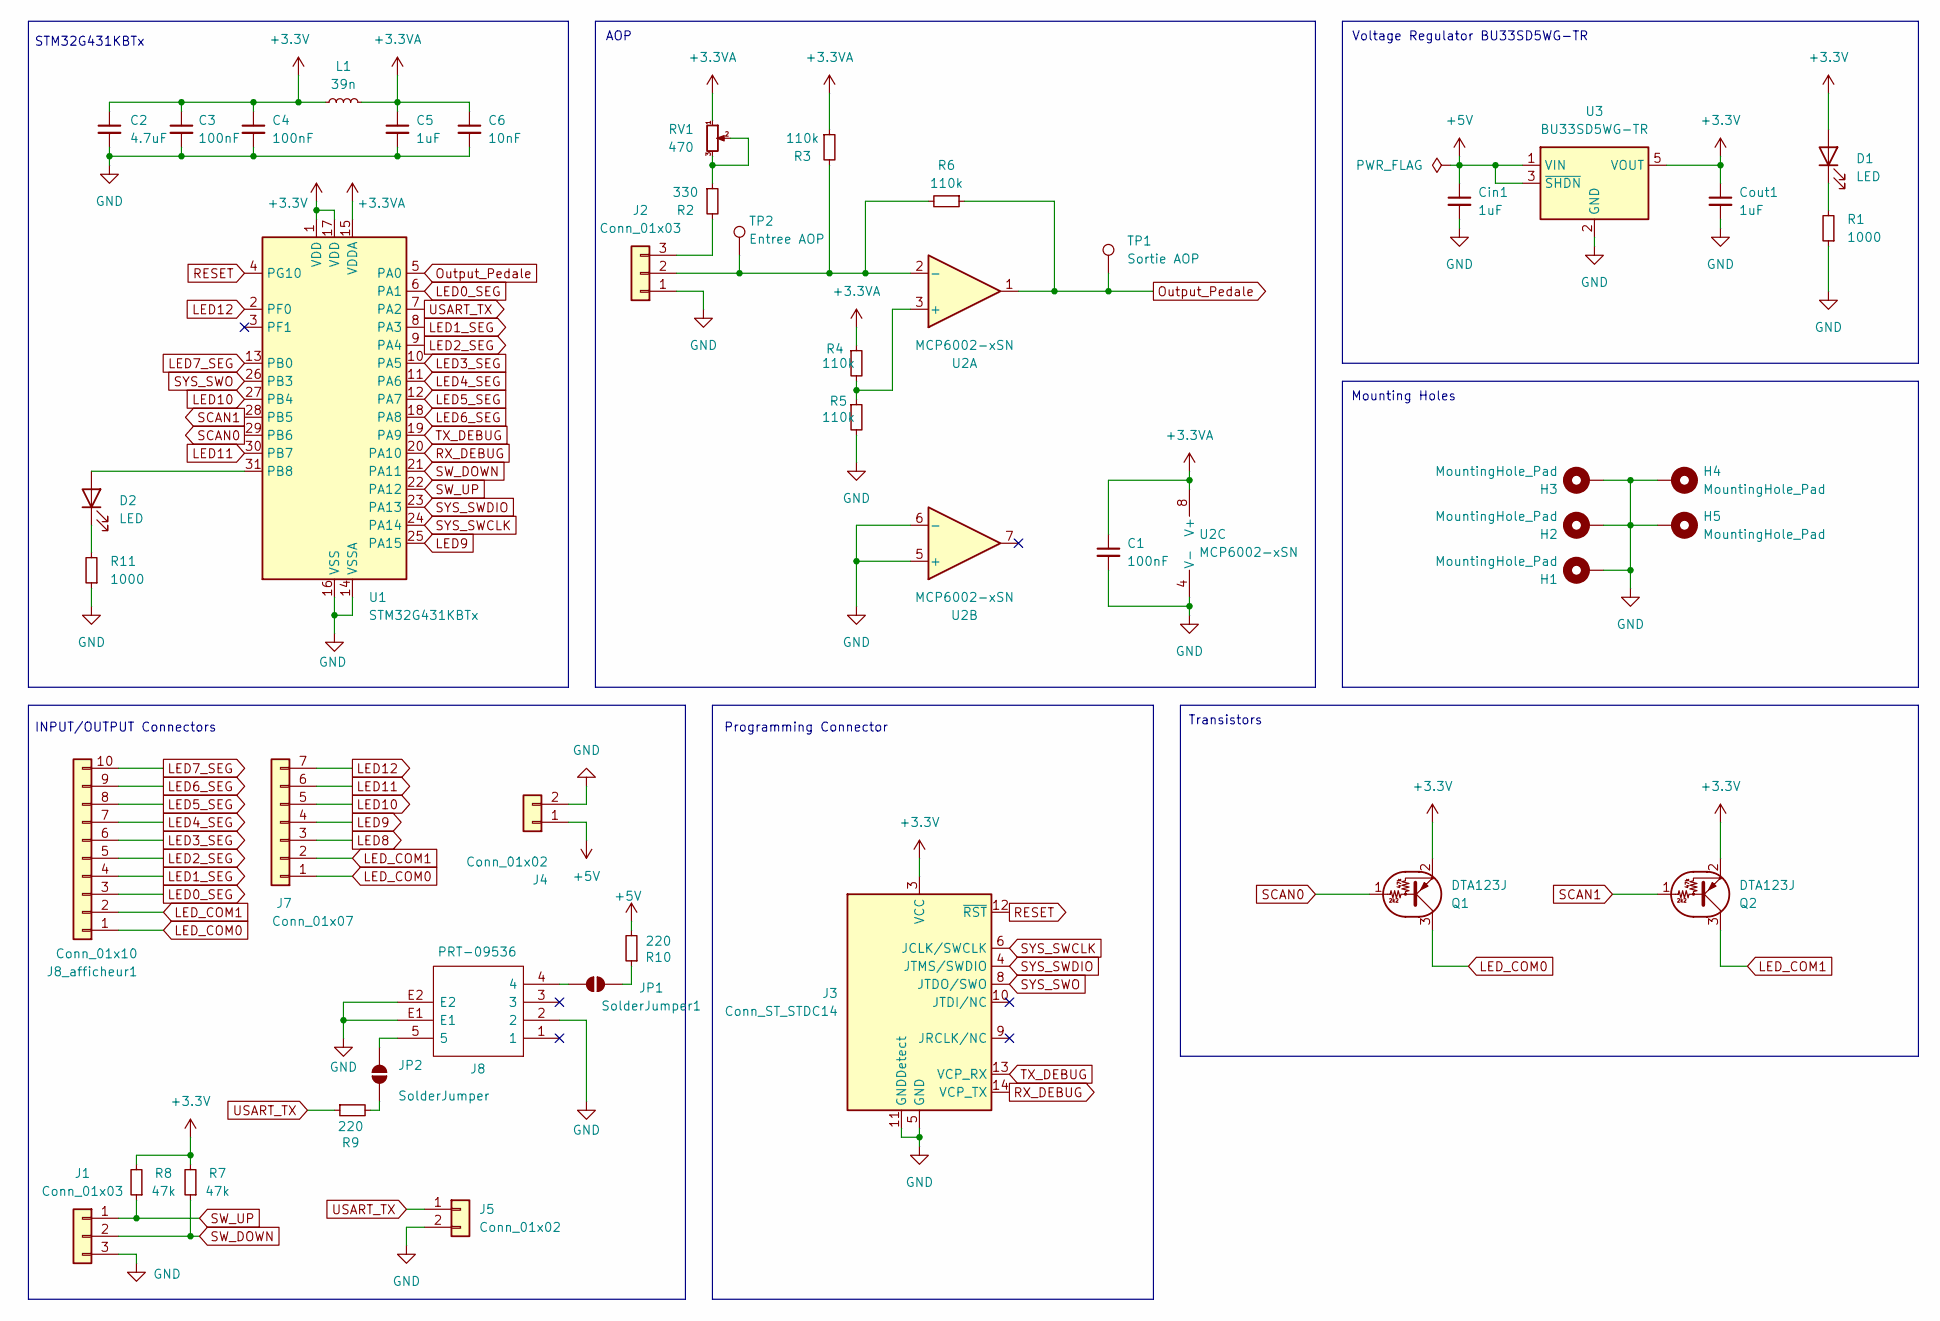
[picture p12: schematic PCB_V1.kicad_sch, 1A1B Projet Pedale]

Parts:
C1, C3, C4: 100nF; C_0402_1005Metric
C2: 4.7uF; C_0603_1608Metric
C5: 1uF; C_0603_1608Metric
C6: 10nF; C_0402_1005Metric
Cin1: 1uF; C_0603_1608Metric
Cout1: 1uF; C_0603_1608Metric
D1, D2: LED; LED_0603_1608Metric
H1, H2, H3, H4, H5: MountingHole_Pad; MountingHole_4mm_Pad_TopBottom
J1, J2: Conn_01x03; JST_XH_B3B-XH-A_1x03_P2.50mm_Vertical
J3: Conn_ST_STDC14; PinHeader_2x07_P1.27mm_Vertical_SMD
J4, J5: Conn_01x02; JST_XH_B2B-XH-A_1x02_P2.50mm_Vertical
J7: Conn_01x07; JST_XH_B7B-XH-A_1x07_P2.50mm_Vertical
J8: PRT-09536; Manufacturer_Part_Number PRT-09536; Mouser Part Number 474-PRT-09536
J8_afficheur1: Conn_01x10; JST_XH_B10B-XH-A_1x10_P2.50mm_Vertical
JP1: SolderJumper1; SolderJumper-2_P1.3mm_Open_TrianglePad1.0x1.5mm
JP2: SolderJumper; SolderJumper-2_P1.3mm_Open_TrianglePad1.0x1.5mm
L1: 39n; L_0603_1608Metric
Q1, Q2: DTA123J; SOT-23-3
R1, R11: 1000; R_0402_1005Metric
R2: 330; R_0402_1005Metric
R3, R4, R5, R6: 110k; R_0402_1005Metric
R7, R8: 47k; R_0402_1005Metric
R9, R10: 220; R_0402_1005Metric
RV1: 470; Potentiometer_Bourns_3314J_Vertical
TP1: Sortie AOP; TestPoint_Pad_D2.0mm
TP2: Entree AOP; TestPoint_Pad_D2.0mm
U1: STM32G431KBTx; LQFP-32_7x7mm_P0.8mm
U2: MCP6002-xSN; SOIC-8_3.9x4.9mm_P1.27mm
U3: BU33SD5WG-TR; SOT-23-5

Connections:
+3.3V: C2.1, C3.1, C4.1, Cout1.1, D1.2 (A), J3.3 (VCC), L1.1, Q1.2 (E), Q2.2 (E), R7.2, R8.2, U1.1 (VDD), U1.17 (VDD), U3.5 (VOUT)
+3.3VA: C1.1, C5.1, C6.1, L1.2, R3.1, R4.1, RV1.1, U1.15 (VDDA), U2.8 (V+)
+5V: Cin1.1, J4.1, R10.2, U3.1 (VIN), U3.3 (~SHDN)
GND: C1.2, C2.2, C3.2, C4.2, C5.2, C6.2, Cin1.2, Cout1.2, H1.1, H2.1, H3.1, H4.1, H5.1, J1.3, J2.1, J3.5 (GND), J3.7 (GND), J3.11 (GNDDetect), J4.2, J5.2, J8.2, J8.E1, J8.E2, R1.1, R5.2, R11.1, U1.14 (VSSA), U1.16 (VSS), U1.32 (VSS), U2.4 (V-), U2.5 (+), U2.6 (-), U3.2 (GND)
LED0_SEG: J8_afficheur1.3, U1.6 (PA1)
LED1_SEG: J8_afficheur1.4, U1.8 (PA3)
LED2_SEG: J8_afficheur1.5, U1.9 (PA4)
LED3_SEG: J8_afficheur1.6, U1.10 (PA5)
LED4_SEG: J8_afficheur1.7, U1.11 (PA6)
LED5_SEG: J8_afficheur1.8, U1.12 (PA7)
LED6_SEG: J8_afficheur1.9, U1.18 (PA8)
LED7_SEG: J8_afficheur1.10, U1.13 (PB0)
LED8: J7.3
LED9: J7.4, U1.25 (PA15)
LED10: J7.5, U1.27 (PB4)
LED11: J7.6, U1.30 (PB7)
LED12: J7.7, U1.2 (PF0)
LED_COM0: J7.1, J8_afficheur1.1, Q1.3 (C)
LED_COM1: J7.2, J8_afficheur1.2, Q2.3 (C)
unnamed: D1.1 (K), R1.2
unnamed: D2.2 (A), U1.31 (PB8)
unnamed: D2.1 (K), R11.2
unnamed: J2.2, R3.2, R6.2, TP2.1, U2.2 (-)
unnamed: J2.3, R2.2
unnamed: J8.4, JP1.1 (A)
unnamed: JP1.2 (B), R10.1
unnamed: JP2.1 (A), R9.2
unnamed: J8.5, JP2.2 (B)
unnamed: R2.1, RV1.2, RV1.3
unnamed: R4.2, R5.1, U2.3 (+)
Output_Pedale: R6.1, TP1.1, U1.5 (PA0), U2.1
RESET: J3.12 (~RST), U1.4 (PG10)
RX_DEBUG: J3.14 (VCP_TX), U1.20 (PA10)
SCAN0: Q1.1 (B), U1.29 (PB6)
SCAN1: Q2.1 (B), U1.28 (PB5)
SW_DOWN: J1.2, R7.1, U1.21 (PA11)
SW_UP: J1.1, R8.1, U1.22 (PA12)
SYS_SWCLK: J3.6 (JCLK/SWCLK), U1.24 (PA14)
SYS_SWDIO: J3.4 (JTMS/SWDIO), U1.23 (PA13)
SYS_SWO: J3.8 (JTDO/SWO), U1.26 (PB3)
TX_DEBUG: J3.13 (VCP_RX), U1.19 (PA9)
USART_TX: J5.1, R9.1, U1.7 (PA2)

Notes on the sheet:
AOP
Voltage Regulator BU33SD5WG-TR
Transistors
Programming Connector
Mounting Holes
STM32G431KBTx
INPUT/OUTPUT Connectors

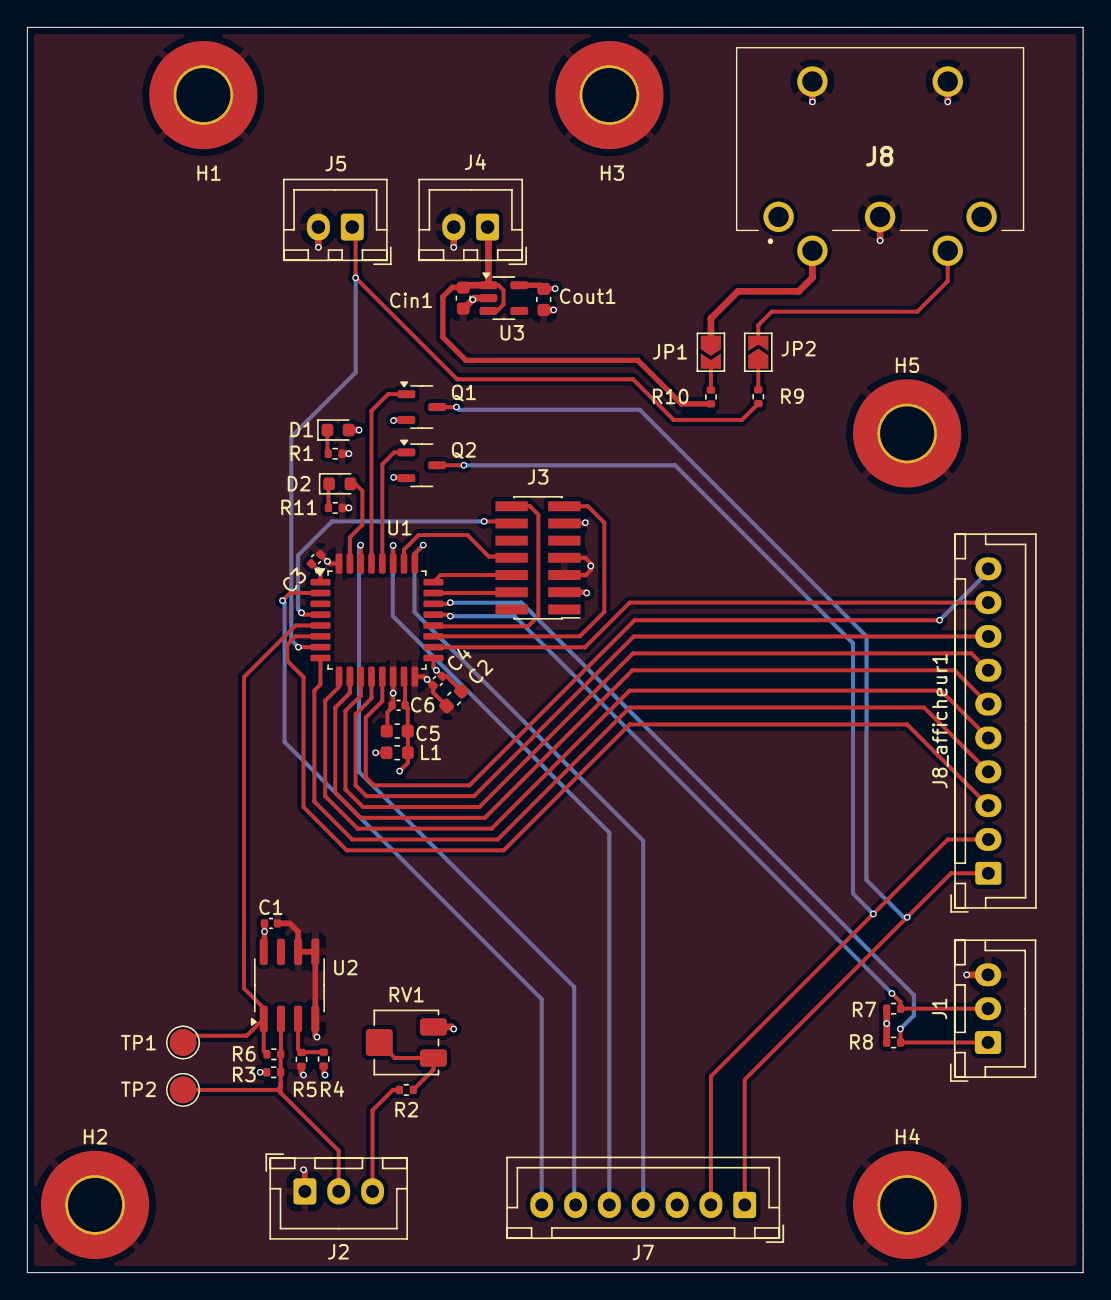
[picture p13: board PCB_V1.kicad_pcb from above]

Board: 4 copper layers, 78.0 x 92.0 mm, 45 parts (0 on the bottom side), 41 nets.
