alexj0i/2425_projet1a_pedale_midi/Software/pdal/Core/Src/main.c

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
/* Includes ------------------------------------------------------------------*/
#include "main.h"
#include "adc.h"
#include "tim.h"
#include "usart.h"
#include "gpio.h"

/* USER CODE BEGIN Includes */
#include "midi.h"
#include "screen.h"
#include <stdio.h>
/* USER CODE END Includes */


void SystemClock_Config(void);
/* USER CODE BEGIN 0 */
int __io_putchar(int chr)
{
	HAL_UART_Transmit(&huart1, (uint8_t*)&chr, 1, HAL_MAX_DELAY);

	return chr;
}

void HAL_TIM_PeriodElapsedCallback(TIM_HandleTypeDef *htim)
{
	if (htim->Instance == TIM4)
	{
		screenDisplay();
		//ControlChange(ADCValue(), EFFECT);
		//printf("%d \r\n", ADCValue());
	}
}

/* Fonction de callback des boutons */
void HAL_GPIO_EXTI_Callback(uint16_t GPIO_Pin)
{
	static int lastButtonTime = 0; // Anti-rebonds

	if ((HAL_GetTick() - lastButtonTime) > 200)
	{ // Anti-rebonds 50ms
		switch(GPIO_Pin)
		{
		case BUTTON_UP:
			globalToDisplay++;
			// Change l'instrument virtuel suivant le numero affiché sur l'ecran en piochant le son associé dans la banque MIDI.
			ProgramChange(globalToDisplay);
			printf("%d \r\n", globalToDisplay);
			if (globalToDisplay > 127) //RQ: pour moi 127 car une data en midi = 1 octet donc au max 128 sons différents possibles
			{
				globalToDisplay=127;
			}
			break;

		case BUTTON_DOWN:
			globalToDisplay--;
			// Change l'instrument virtuel suivant le numero affiché sur l'ecran en piochant le son associé dans la banque MIDI.
			ProgramChange(globalToDisplay);
			printf("%d \r\n", globalToDisplay);
			if (globalToDisplay < 0)
			{
				globalToDisplay=0;
			}
			break;
		}

		lastButtonTime = HAL_GetTick();
	}
}
/* USER CODE END 0 */

/**
  * @brief  The application entry point.
  * @retval int
  */
int main(void)
{

  /* MCU Configuration--------------------------------------------------------*/

  /* Reset of all peripherals, Initializes the Flash interface and the Systick. */
  HAL_Init();

  /* Configure the system clock */
  SystemClock_Config();

  /* Initialize all configured peripherals */
  MX_GPIO_Init();
  MX_USART1_UART_Init();
  MX_ADC1_Init();
  MX_TIM4_Init();
  /* USER CODE BEGIN 2 */
  globalToDisplay = 0;                // Valeur de départ « 00 »

  HAL_TIM_Base_Start_IT(&htim4);      // démarre le multiplexage

  printf("Test\r\n");
  /* USER CODE END 2 */

  /* Infinite loop */
  /* USER CODE BEGIN WHILE */
	while (1)
	{
		// HAL_PWR_EnterSLEEPMode(PWR_MAINREGULATOR_ON, PWR_SLEEPENTRY_WFI);

    /* USER CODE END WHILE */
		HAL_GPIO_WritePin(GPIOB,GPIO_PIN_8,1);
		HAL_Delay(100);
		HAL_GPIO_WritePin(GPIOB,GPIO_PIN_8,0);
		HAL_Delay(100);
    /* USER CODE BEGIN 3 */
	}
  /* USER CODE END 3 */
}

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
