alexj0i/2425_projet1a_pedale_midi/Software/pdal/pdal.ioc

Mcu.UserName=STM32G431KBTx
PA0.Signal=ADC1_IN1
PA1.Signal=GPIO_Output
PA10.Signal=USART1_RX
PA11.Signal=GPXTI11
PA12.Signal=GPXTI12
PA13.Signal=SYS_JTMS-SWDIO
PA14.Signal=SYS_JTCK-SWCLK
PA15.Signal=GPIO_Output
PA3.Signal=GPIO_Output
PA4.Signal=GPIO_Output
PA5.Signal=GPIO_Output
PA6.Signal=GPIO_Output
PA7.Signal=GPIO_Output
PA8.Signal=GPIO_Output
PA9.Signal=USART1_TX
PB0.Signal=GPIO_Output
PB3.Signal=SYS_JTDO-SWO
PB4.Signal=GPIO_Output
PB5.Signal=GPIO_Output
PB6.Signal=GPIO_Output
PB7.Signal=GPIO_Output
PB8-BOOT0.GPIO_Label=LED_STATUS
PB8-BOOT0.Signal=GPIO_Output
PF0-OSC_IN.Signal=GPIO_Output
