alexj0i/2425_projet1a_pedale_midi/(commit log)

2025-02-10 ajout datasheets PCB et capteur pedale
2025-03-03 Version 1 Schema PCB
    [PCB_V1.kicad_pcb, PCB_V1.kicad_sch]
2025-03-03 +2 gros boutons
    [PCB_V1.kicad_sch]
2025-03-10 mise à jour Schema + fichier IOC
    [PCB_V1.kicad_pcb, PCB_V1.kicad_sch]
2025-03-10 ajout transistors LED
    [PCB_V1.kicad_sch]
2025-03-11 Mis à jour schématique
    [PCB_V1.kicad_sch]
2025-04-07 ajout library footprint DIN5
    [EDI2CAP.CFG, PCB_V1.kicad_pcb, PCB_V1.kicad_sch, PRT-09536.stp, chips.prt, prt09536.psm]
2025-04-07 pcb complet
    [PCB_V1-B_Cu.gbr, PCB_V1-B_Mask.gbr, PCB_V1-B_Silkscreen.gbr, PCB_V1-Edge_Cuts.gbr, PCB_V1-F_Cu.gbr, PCB_V1-F_Mask.gbr, PCB_V1-F_Paste.gbr, PCB_V1-F_Silkscreen.gbr]
2025-04-28 gerber 2
    [PCB_V1-B_Cu.gbr, PCB_V1-B_Mask.gbr, PCB_V1-B_Silkscreen.gbr, PCB_V1-Edge_Cuts.gbr, PCB_V1-F_Cu.gbr, PCB_V1-F_Mask.gbr, PCB_V1-F_Paste.gbr, PCB_V1-F_Silkscreen.gbr]
