alexj0i/2425_projet1a_pedale_midi/(notices)

Notices in the files:
Software/pdal/Core/Src/main.c:
Copyright (c) 2025 STMicroelectronics.
All rights reserved.
This software is licensed under terms that can be found in the LICENSE file
